FerralCoder/RZR_Ignition_Delay_Indicator/schematics/RZR_Ignition_Delay_Timer_v4.sch

## EAGLE design schematics/RZR_Ignition_Delay_Timer_v4.sch (2024-03-21)

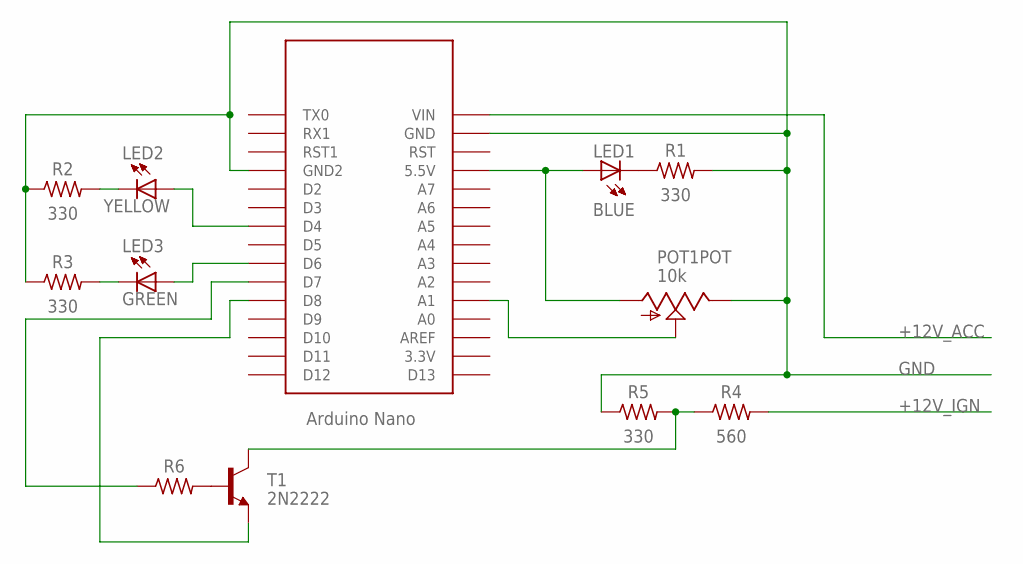
[picture p1: schematic RZR_Ignition_Delay_Timer_v4.sch]

Parts:
LED1: BLUE; SMLK34
LED2: YELLOW; SMLK34
LED3: GREEN; SMLK34
POT1: 10k; THUMBWHEELV
R1, R2, R3, R5: 330; RESAD724W46L381D178B
R4, R6: 560; RESAD724W46L381D178B
T1: 2N2222; TO92-EBC-OVAL
U$1: NANO

Connections:
+12V_ACC: U$1.VIN
+12V_IGN: R4.2
GND: POT1.E, R1.2, R2.1, R3.1, R5.1, U$1.GND, U$1.GND1 (GND2)
unnamed: LED2.K (C), R2.2
unnamed: LED1.K (C), R1.1
unnamed: R6.2, T1.B
unnamed: R6.1, U$1.D7
unnamed: LED1.A, POT1.A, U$1.5V (5.5V)
unnamed: T1.E, U$1.D8
unnamed: R4.1, R5.2, T1.C
unnamed: LED3.K (C), R3.2
unnamed: LED3.A, U$1.D6
unnamed: LED2.A, U$1.D4
unnamed: POT1.S, U$1.A1
