FerralCoder/RZR_Ignition_Delay_Indicator/(commit log)

2024-03-19 Add Ignition Isolation
    Found Ignition wire to be normally high, even when accessory power is not turned on. This was causing leakage current on the IgnitionPin input to partially power the uC when accessory power was off. Added a transistor to the circuit to use a digital switch to isolate that input until the uC is ready for it.
    [PinAssignments.h, UTV_Holeshot_Hero_Maker.ino]
2024-03-19 Change timer delay range
    Based on in-vehicle observation, changes delay range to 500 - 3500 ms
2024-03-21 Add schematic files
    Autodesk Fusion 360 and Eagle formats
    [RZR_Ignition_Delay_Timer_v4.sch]
